jeferson-scheibler/pinballAutoma/README.md

# Mesa de pinball autonoma
## Objetivo / Ideia
Esse foi um projeto desenvolvido pelo Laboratório de automação (Univates) em conjuto com o professor Alexandre Wolf.
A ideia é desenvolver duas mesas de pinball que podem jogar sozinhas, ou de forma manual. As duas mesas serão colocadas frente a frente, tendo o objetivo de lançar a bolinha para o outro lado e ir pontuando conforme a bolinha for batendo nos cantos. </br>
A automação da mesa será feita através de uma câmera apontada em direção a mesa que será responsavel por "enxergar" a bolinha e algumas marcações da mesa para localizar onde a bolinha se encontra, a area na qual os batedores atuam e a area de lançamento da bolinha. </br>
Para seu funcionamento autonomo se tem 2 formas de funcionamento:
- Algoritmo ("Math"): detecta a bolinha com HoughCircles (OpenCV) e a base dos batedores por uma marcação colorida na mesa (vermelha por padrão, faixa HSV calibrável).
- IA ("Ai"): detecta a bolinha com um modelo YOLOv5 treinado (`Python/YoloModel/best256pV9.onnx`, classes `bola` e `batedor`), executado pelo OpenCV (sem PyTorch).

Em ambos os modos a bolinha é rastreada (filtro de Kalman) e, se a trajetória prevista chegar à área de um batedor dentro do tempo de reação do sistema, o PC envia o comando para o Arduino.

## Execução
### Mesa:
As mesas foram construidas toda em mdf e seus componentes eletronicos são (cada uma):
- 3 Push buttons com led, utilizado para os comandos
- 8 Botões de fim de curso, utilizado para capturar o impacto da bolinha em alguns cantos
- 3 Solenoides, utilizadas para os comandos do braço esquerdo, direito e lançamento da bolinha
- 1 módulo relé, utilizado para alimentar as solenoides
- 8 leds RGB
- 1 arduino mega, utilizado para controlar todos os componentes e se comunicar com o PC (explicação a frente)
- 1 Fonte de computador 400W+ utilizada para ambas as mesas
As mesas são espelhadas e identicas, todos os conectores e comandos serão iguais em ambos os lados

### Esquema eletrico/pinos
<p align="center">
  
</p>
As solenoides estão ligadas a um módulo relé que está sendo controlado pelo arduino

### Pc:

O PC será responsavel por controlar as mesas e utilizará comunicação serial para conversar com os arduinos.

### Automação:

O script principal fica em `Python/main/main.py`:

```bash
pip install -r Python/requirements.txt
python Python/main/calibracao.py --camera 0
python Python/main/main.py --porta COM3 --camera 0
```

#### Calibração (`calibracao.py`)
Todos os parâmetros ficam em `Python/main/config.json`, gerado pela ferramenta de calibração (tecla `s` salva). Modos:

| Tecla | Ajuste |
|---|---|
| `1` / `2` | faixa HSV da marcação da base dos batedores / do lançador (janela "Mascara" mostra o resultado) |
| `3` | detecção da bolinha (raios e parâmetros do HoughCircles) |
| `4` | tamanho da área dos batedores, latência e cooldown |
| `5` | exposição e balanço de branco da câmera (fixá-los deixa as cores estáveis) |
| `p` | marcar os 4 cantos da mesa (sup. esq., sup. dir., inf. dir., inf. esq.) para usar coordenadas da mesa |
| `c` | ativar/desativar a perspectiva |

Com a perspectiva ativa, as medidas da área dos batedores passam a ser em unidades da mesa (`largura_mesa` x `altura_mesa`, padrão 400 x 800), independentes da posição da câmera; reajuste-as no modo `4`.

#### Previsão e disparo
A bolinha é rastreada com um filtro de Kalman (posição e velocidade, usando o tempo real entre quadros). O batedor é acionado quando a trajetória prevista entra na área dos batedores dentro da `latencia_ms` (atraso entre o quadro e o braço em movimento), e o lado é definido pelo ponto de entrada. Para ajustar a latência: se o braço bate depois da bolinha passar, aumente; se bate cedo demais, diminua.

Opções principais do `main.py`:
- `--config`: arquivo de configuração (padrão `Python/main/config.json`)
- `--porta` / `--baud`: porta serial do Arduino (ex.: `COM3`, `/dev/ttyACM0`; padrão 115200 baud)
- `--camera`: índice da câmera
- `--modo math|ai`: modo inicial (tecla `t` alterna durante a execução, `r` zera o placar, `Esc` sai)
- `--lancador`: habilita o lançamento automático quando a bolinha está parada na área do lançador
- `--backend opencv|onnxruntime|torch`: execução do modelo no modo IA. O padrão `opencv` não precisa de PyTorch nem de internet; `onnxruntime` requer `pip install onnxruntime`; `torch` usa o `torch.hub` (para modelos `.pt`)
- `--yolov5-local`: clone local do yolov5 para o backend `torch` sem internet
- `--sem-serial`: roda apenas a visão, sem Arduino

#### Placar e comunicação com o Arduino
A tela mostra o modo do Arduino (automático/manual), o placar (total de impactos nos sensores) e o último sensor atingido. O PC pede o status a cada 1 s; se o Arduino não responder por 3 s, aparece **SEM RESPOSTA** em vermelho. No modo manual do Arduino o PC não envia comandos dos batedores.

Para duas mesas, rode uma instância por mesa, cada uma com sua câmera, porta e configuração (`--camera`, `--porta`, `--config`).

Protocolo serial (115200 baud):

| PC → Arduino | Ação |
|---|---|
| `1` / `2` / `3` | pulso no braço esquerdo / direito / lançador (somente no modo automático) |
| `?` | pede o status |
| `r` | zera o placar |

| Arduino → PC | Significado |
|---|---|
| `S,<modo>,<total>,<g0>,<g1>,<g2>,<g3>` | status: modo (0 automático, 1 manual), placar total e nível de cor de cada grupo de LEDs; enviado no início, após `?`, `r` e troca de modo |
| `H,<sensor>,<total>` | sensor de impacto atingido e placar atualizado |

No Arduino, segurar os botões esquerdo e direito por 1 s alterna entre modo automático e manual. Por segurança, os solenoides acionados pelos botões desligam após 1,5 s mesmo com o botão pressionado (`MAX_ACIONADO_MS`).

## Raspberry Pi 4, PC de IA e servidor (VM)

```
câmeras + Arduinos ─USB─▶ Raspberry Pi 4 ── modo Math local (controla as mesas, sem depender da rede)
                               │  ▲
          rede local cabeada   │  │ comandos (só enquanto o PC controla a mesa)
                               ▼  │
                          PC de IA (main.py --pi)
                               │
     internet (TLS, conexão aberta pelo Pi) ──▶ VM: placar e vídeo na web (servidor_vm.py)
```

- O **Pi** roda o modo Math das duas mesas. Se a rede cair, as mesas continuam jogando.
- Um **PC na rede local** pode assumir uma mesa no modo IA. O Pi envia os quadros com o instante da captura e repassa os comandos ao Arduino. Se o PC ficar 1 s sem responder, a mesa volta sozinha ao Math.
- A **VM** recebe placar, status e vídeo reduzido por uma conexão TLS **aberta pelo Pi** (não é preciso liberar portas no laboratório). A VM só pode zerar o placar; ela nunca aciona os solenoides.

### Raspberry Pi 4
1. Raspberry Pi OS 64 bits, projeto em `/home/pi/mesaPinball`:
   ```bash
   python3 -m venv .venv && .venv/bin/pip install -r Python/requirements.txt
   ```
   No Pi, prefira `opencv-python-headless` (sem janelas).
2. Nomes fixos para os Arduinos: edite os números de série em `deploy/99-mesas-pinball.rules` e copie para `/etc/udev/rules.d/`. As câmeras podem ser indicadas pelo caminho estável em `/dev/v4l/by-id/`.
3. Copie `Python/main/pi.exemplo.json` para `pi.json` e ajuste câmeras, portas e o IP da VM. A calibração de cada mesa fica em `config_mesa1.json` / `config_mesa2.json` (gerados pelo `calibracao.py --config ...`). No Pi, use `"intervalo_quadros": 5` em `batedores` para economizar CPU.
4. Tokens em `/etc/pinball/pi.env` (permissão 600): `PINBALL_TOKEN_LAN=...` e `PINBALL_TOKEN_VM=...`. Gere com `python3 -c "import secrets; print(secrets.token_urlsafe(32))"`.
5. Copie o certificado público da VM para `Python/main/vm.crt` e instale o serviço `deploy/pinball-pi.service`.

Ligue as duas câmeras nas portas USB 3 (azuis), use fonte oficial de 5 V / 3 A e, se possível, um hub USB com fonte própria para os Arduinos.

### VM (servidor da universidade)
> **VM com domínio (recomendado):** para publicar a página em `https://SEU-DOMINIO/mesa-pinball/` atrás do nginx,
> com o Pi conectando em `SEU-DOMINIO:8443` e renovação automática do certificado, siga
> [docs/CONFIGURAR_VM_DATI.md](docs/CONFIGURAR_VM_DATI.md). Os arquivos estão em `deploy/`
> (`nginx-mesa-pinball.conf`, `certbot-deploy-hook-pinball.sh`, `pinball-vm.service`). O servidor aceita `--web-http`
> (página em HTTP só em 127.0.0.1, atrás do proxy) e bloqueia por 10 minutos os IPs que erram o token ou a senha 8 vezes.
> As instruções abaixo valem para uma VM sem domínio, acessada direto por IP.

Precisa apenas de Python 3.8+ (sem pacotes extras).
1. Certificado: com domínio, use Let's Encrypt; só com IP, gere um autoassinado e copie o `.crt` para o Pi:
   ```bash
   openssl req -x509 -newkey rsa:2048 -nodes -days 825 -keyout servidor.key -out servidor.crt -subj "/CN=IP-DA-VM" -addext "subjectAltName=IP:IP-DA-VM"
   ```
2. `/etc/pinball/vm.env` (permissão 600): `PINBALL_TOKEN_VM` (o mesmo do Pi), `PINBALL_WEB_USUARIO` e `PINBALL_WEB_SENHA`.
3. Instale `deploy/pinball-vm.service` e libere no firewall as portas 8443 (Pi) e 8444 (página web).
4. Acesse `https://IP-DA-VM:8444` com o usuário e a senha.

### PC de IA (rede local)
```bash
python Python/main/main.py --pi IP-DO-PI --mesa 1 --token TOKEN_LAN --modo ai --latencia-ms 110
```
A configuração da mesa vem do Pi. A tela mostra a latência medida pelo Pi (captura → comando); some o tempo do relé e do solenoide (~20–30 ms) para ajustar `--latencia-ms`. O token também pode vir da variável `PINBALL_TOKEN_LAN`.
