jeferson-scheibler/pinballAutoma/docs/pinagem_mesa_pinball_A3.pdf

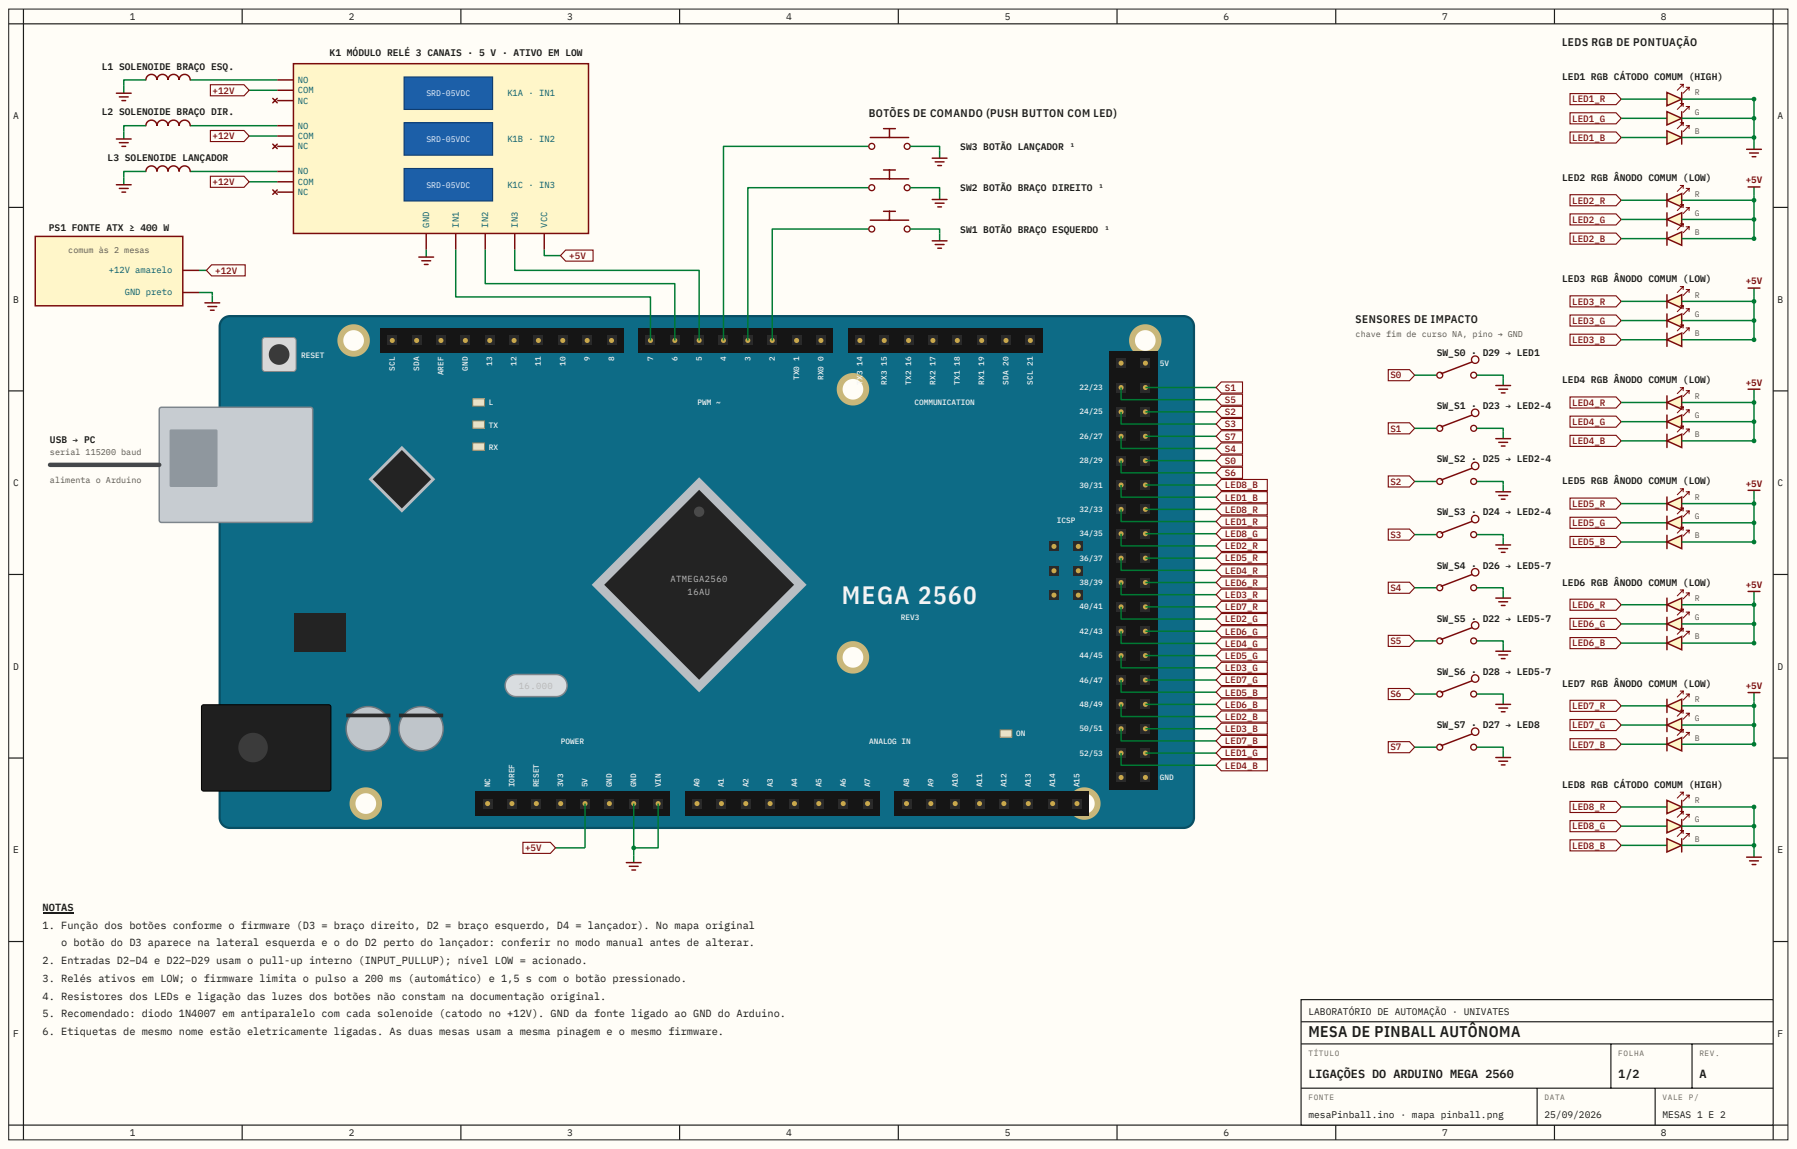
[picture p1: page 1]

LEDS RGB DE PONTUAÇÃO

LED1 RGB CÁTODO COMUM (HIGH)

BOTÕES DE COMANDO (PUSH BUTTON COM LED)

LED2 RGB ÂNODO COMUM (LOW)

LED3 RGB ÂNODO COMUM (LOW)

SENSORES DE IMPACTO
chave fim de curso NA, pino → GND

LED4 RGB ÂNODO COMUM (LOW)

LED5 RGB ÂNODO COMUM (LOW)

LED6 RGB ÂNODO COMUM (LOW)

LED7 RGB ÂNODO COMUM (LOW)

LED8 RGB CÁTODO COMUM (HIGH)

NOTAS
1. Função dos botões conforme o firmware (D3 = braço direito, D2 = braço esquerdo, D4 = lançador). No mapa original
3. Relés ativos em LOW; o firmware limita o pulso a 200 ms (automático) e 1,5 s com o botão pressionado.
5. Recomendado: diodo 1N4007 em antiparalelo com cada solenoide (catodo no +12V). GND da fonte ligado ao GND do Arduino.

LABORATÓRIO DE AUTOMAÇÃO · UNIVATES
MESA DE PINBALL AUTÔNOMA

TÍTULO
LIGAÇÕES DO ARDUINO MEGA 2560

FONTE
mesaPinball.ino · mapa pinball.png

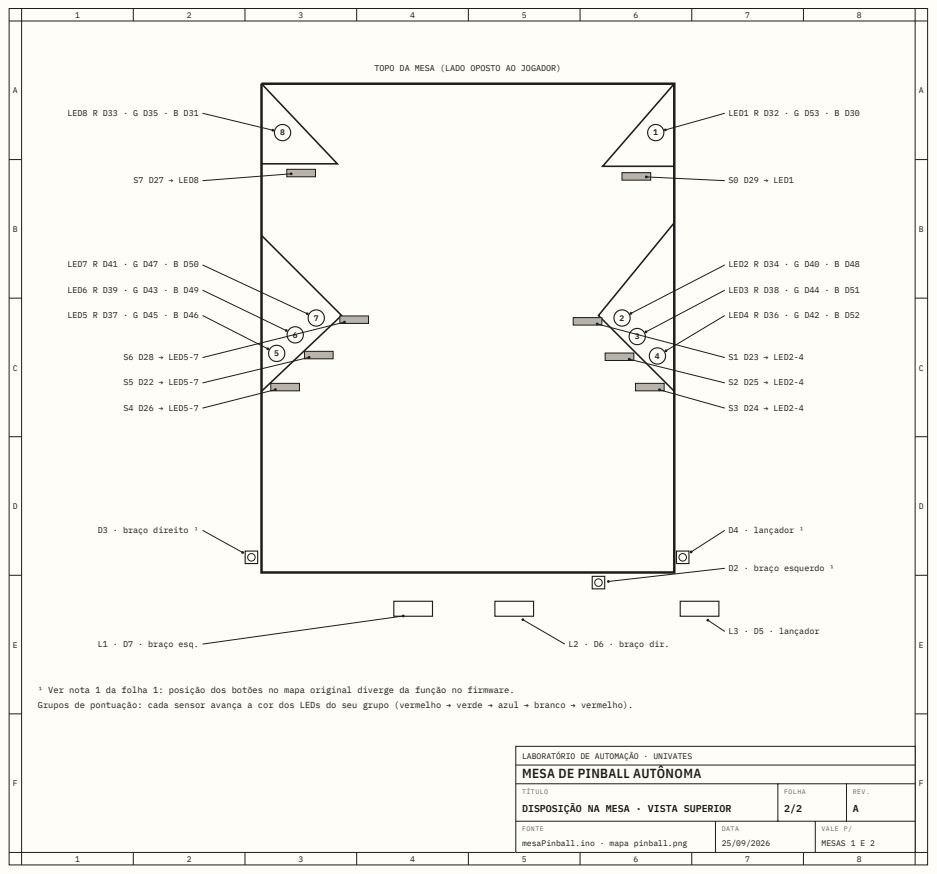
[picture p2: page 2]

MESA DE PINBALL AUTÔNOMA

TÍTULO
DISPOSIÇÃO NA MESA · VISTA SUPERIOR

FONTE
mesaPinball.ino · mapa pinball.png

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
P I N O | D I R E Ç Ã O | R E D E | L I G A D O A | L Ó G I C A
D 2 | E N T R A D A | — | S W 1 b o t ã o b r a ç o e s q u e r d o ¹ | L O W = p r e s s i o n a d o
D 3 | E N T R A D A | — | S W 2 b o t ã o b r a ç o d i r e i t o ¹ | L O W = p r e s s i o n a d o
D 4 | E N T R A D A | — | S W 3 b o t ã o l a n ç a d o r ¹ | L O W = p r e s s i o n a d o
D 5 | S A Í D A | — | K 1 I N 3 → s o l e n o i d e L 3 , l a n ç a d o r | L O W a c i o n a
D 6 | S A Í D A | — | K 1 I N 2 → s o l e n o i d e L 2 , b r a ç o d i r e i t o | L O W a c i o n a
D 7 | S A Í D A | — | K 1 I N 1 → s o l e n o i d e L 1 , b r a ç o e s q u e r d o | L O W a c i o n a
D 2 2 | E N T R A D A | S 5 | S W _ S 5 s e n s o r d e i m p a c t o → g r u p o L E D 5 -7 | L O W = a t i n g i d o
D 2 3 | E N T R A D A | S 1 | S W _ S 1 s e n s o r d e i m p a c t o → g r u p o L E D 2 -4 | L O W = a t i n g i d o
D 2 4 | E N T R A D A | S 3 | S W _ S 3 s e n s o r d e i m p a c t o → g r u p o L E D 2 -4 | L O W = a t i n g i d o
D 2 5 | E N T R A D A | S 2 | S W _ S 2 s e n s o r d e i m p a c t o → g r u p o L E D 2 -4 | L O W = a t i n g i d o
D 2 6 | E N T R A D A | S 4 | S W _ S 4 s e n s o r d e i m p a c t o → g r u p o L E D 5 -7 | L O W = a t i n g i d o
D 2 7 | E N T R A D A | S 7 | S W _ S 7 s e n s o r d e i m p a c t o → g r u p o L E D 8 | L O W = a t i n g i d o
D 2 8 | E N T R A D A | S 6 | S W _ S 6 s e n s o r d e i m p a c t o → g r u p o L E D 5 -7 | L O W = a t i n g i d o
D 2 9 | E N T R A D A | S 0 | S W _ S 0 s e n s o r d e i m p a c t o → g r u p o L E D 1 | L O W = a t i n g i d o
D 3 0 | S A Í D A | L E D 1 _ B | L E D 1 a z u l ( c á t o d o c o m u m ) | H I G H a c e n d e
D 3 1 | S A Í D A | L E D 8 _ B | L E D 8 a z u l ( c á t o d o c o m u m ) | H I G H a c e n d e
D 3 2 | S A Í D A | L E D 1 _ R | L E D 1 v e r m e l h o ( c á t o d o c o m u m ) | H I G H a c e n d e
D 3 3 | S A Í D A | L E D 8 _ R | L E D 8 v e r m e l h o ( c á t o d o c o m u m ) | H I G H a c e n d e
D 3 4 | S A Í D A | L E D 2 _ R | L E D 2 v e r m e l h o ( â n o d o c o m u m ) | L O W a c e n d e
D 3 5 | S A Í D A | L E D 8 _ G | L E D 8 v e r d e ( c á t o d o c o m u m ) | H I G H a c e n d e
D 3 6 | S A Í D A | L E D 4 _ R | L E D 4 v e r m e l h o ( â n o d o c o m u m ) | L O W a c e n d e
D 3 7 | S A Í D A | L E D 5 _ R | L E D 5 v e r m e l h o ( â n o d o c o m u m ) | L O W a c e n d e
D 3 8 | S A Í D A | L E D 3 _ R | L E D 3 v e r m e l h o ( â n o d o c o m u m ) | L O W a c e n d e
D 3 9 | S A Í D A | L E D 6 _ R | L E D 6 v e r m e l h o ( â n o d o c o m u m ) | L O W a c e n d e
D 4 0 | S A Í D A | L E D 2 _ G | L E D 2 v e r d e ( â n o d o c o m u m ) | L O W a c e n d e
D 4 1 | S A Í D A | L E D 7 _ R | L E D 7 v e r m e l h o ( â n o d o c o m u m ) | L O W a c e n d e
D 4 2 | S A Í D A | L E D 4 _ G | L E D 4 v e r d e ( â n o d o c o m u m ) | L O W a c e n d e
D 4 3 | S A Í D A | L E D 6 _ G | L E D 6 v e r d e ( â n o d o c o m u m ) | L O W a c e n d e
D 4 4 | S A Í D A | L E D 3 _ G | L E D 3 v e r d e ( â n o d o c o m u m ) | L O W a c e n d e
D 4 5 | S A Í D A | L E D 5 _ G | L E D 5 v e r d e ( â n o d o c o m u m ) | L O W a c e n d e
D 4 6 | S A Í D A | L E D 5 _ B | L E D 5 a z u l ( â n o d o c o m u m ) | L O W a c e n d e
D 4 7 | S A Í D A | L E D 7 _ G | L E D 7 v e r d e ( â n o d o c o m u m ) | L O W a c e n d e
D 4 8 | S A Í D A | L E D 2 _ B | L E D 2 a z u l ( â n o d o c o m u m ) | L O W a c e n d e
D 4 9 | S A Í D A | L E D 6 _ B | L E D 6 a z u l ( â n o d o c o m u m ) | L O W a c e n d e
D 5 0 | S A Í D A | L E D 7 _ B | L E D 7 a z u l ( â n o d o c o m u m ) | L O W a c e n d e
D 5 1 | S A Í D A | L E D 3 _ B | L E D 3 a z u l ( â n o d o c o m u m ) | L O W a c e n d e
D 5 2 | S A Í D A | L E D 4 _ B | L E D 4 a z u l ( â n o d o c o m u m ) | L O W a c e n d e
D 5 3 | S A Í D A | L E D 1 _ G | L E D 1 v e r d e ( c á t o d o c o m u m ) | H I G H a c e n d e
