jeferson-scheibler/pinballAutoma/(commit log)

2026-09-25 Corrige bugs de detecção, acionamento e firmware da mesa
    Python (Python/main):
    - mesa: estado por instância; conversão para int evita OverflowError
    de uint16 no NumPy 2.x (previsão falhava com bolinha indo para a
    esquerda/cima); detecções vazias não entram no histórico; cooldown
    por batedor evita enviar o comando a cada quadro
    - deepLearning: filtra a classe 'bola' pela maior confiança; caminho do
    modelo independe do diretório; opção de yolov5 local (offline)
    - main: escala correta do modo IA (800/256); base dos batedores
    atualizada nos dois modos; lançamento automático opcional (--lancador);
    checagem de falha da câmera; porta/câmera por argumentos; espera o
    re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
    [PinballMesa - To rasp.py, PinballMesa.py, deepLearning.py, main.py, mesa.py, mesaPinball.ino, traditional.py]
2026-09-25 Arduino: cores dos LEDs de pontuacao ciclam em vez de travar no branco
2026-09-25 Previsão por tempo de chegada, filtro de Kalman e calibração por config
    Previsão (item 1):
    - rastreador.py: filtro de Kalman de velocidade constante usando o dt
    real entre quadros (independe do FPS); tolera quadros sem detecção e
    reinicia em saltos incompatíveis com a trajetória
    - mesa.py: dispara quando a trajetória prevista entra na área dos
    batedores dentro da latência do sistema (câmera + serial + relé +
    solenoide); lado definido pelo ponto de entrada; base suavizada;
    lançador só dispara com a bolinha parada
    - perspectiva.py: coordenadas da mesa via homografia dos 4 cantos
    Calibração (item 2):
    - config.py: parâmetros em config.json com valores padrão
    - tradi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
2026-09-25 Modo IA sem PyTorch, busca por ROI e comunicação bidirecional com placar
    Desempenho e portabilidade (item 3):
    - deepLearning: modelo ONNX executado pelo OpenCV DNN por padrão (sem
    PyTorch e sem internet); backends onnxruntime e torch opcionais;
    decodificação YOLOv5 com NMS por classe
    - traditional: HoughCircles procura primeiro numa região em volta da
    posição prevista (~9x mais rápido), com fallback na imagem inteira
    - requirements.txt reduzido a numpy, opencv-python e pyserial
    Comunicação nos dois sentidos (item 4):
    - Firmware: 115200 baud; envia status (S) e impactos (H); aceita '?'
    (status) e 'r' (zerar placar); placar total de impactos
    - arduino.py: leitura não bloqu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
2026-09-25 Arduino: corrige literais '\n' quebrados que impediam a compilacao
    [mesaPinball.ino]
2026-09-29 Raspberry Pi 4 com modo Math local, PC de IA na rede e painel na VM
    - pi_agente.py: o Pi controla as duas mesas no modo Math, sem depender
    da rede; atende um PC de IA por mesa na rede local (token) e volta ao
    Math sozinho se o PC parar de responder; envia status, placar e vídeo
    reduzido para a VM por conexão TLS de saída, com reconexão automática
    - servidor_vm.py: servidor só com a biblioteca padrão; recebe o Pi por
    TLS e mostra vídeo e placar numa página HTTPS com senha; a VM só pode
    zerar o placar (com proteção contra CSRF), nunca aciona solenoides
    - rede.py + main.py --pi: o PC recebe os quadros com o instante de
    captura do Pi e envia os comandos; usa o relógio do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
2026-09-29 Fixa LF nos arquivos usados no Raspberry Pi e na VM
2026-09-30 Adiciona PDF da pinagem do Arduino Mega (A3)
    Folha 1: ligacoes do Arduino Mega 2560; folha 2: disposicao na mesa;
    lista de ligacoes com os 38 pinos.
2026-09-30 Servidor da VM atras do nginx em /mesa-pinball/ e guia de configuracao
    - servidor_vm: pagina com enderecos relativos (funciona em qualquer
    caminho); --web-http serve HTTP so em 127.0.0.1 para ficar atras do
    proxy; recarrega o certificado com SIGHUP sem derrubar o Pi
    - Seguranca da porta 8443 exposta: bloqueio por 10 min dos IPs que erram
    o token ou a senha 8 vezes (IP real via X-Real-IP do nginx), limite de
    conexoes ainda nao autenticadas, so aceita mesas anunciadas no hello,
    X-Accel-Buffering para o video
    - deploy: servico atualizado, trecho do nginx e hook de renovacao do
    certbot; pi.exemplo.json aponta para o dominio (sem vm.crt)
    - docs/CONFIGURAR_VM_DATI.md: roteiro autossufi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
